sfambach/arduino-atari2600-cart-reader/README.md

# Atari 2600 Cartridge Reader

Arduino firmware for dumping Atari 2600 cartridges, including bankswitched games.

Project page: https://www.fambach.net/ (Retro Projekt – Atari 2600 ROM einlesen)

## Boards

| Board | Address bus | Data bus |
|---|---|---|
| Arduino Mega 2560 | A0-A7 = PA0-PA7, A8-A12 = PC0-PC4 | D0-D7 = PL0-PL7 |
| Arduino Uno / Nano | 2 × 74HC595 on SPI (MOSI D11, SCK D13, latch A2): U1 = A0-A7, U2 = A8-A12 | D0-D7 = D2-D9 |
| Uno / Nano, MCP23017 boards | MCP23017 (I2C 0x20): GPA0-7 = A0-A7, GPB0-4 = A8-A12; `#define ADDR_MCP23017` in `hal.h` | D0-D7 = D2-D9 |

Cartridge slot: pin 23 = switched +5 V (BC327, LOW on D10 for Uno/Nano, D8 for Mega; sense on A0), pins 12 and 24 = GND. Read button on A1; reset button on the Arduino RESET line (Uno and Mega shields).

Boards (THT, KiCad) for Uno, Mega and Nano, plus MCP23017 variants for Uno and Nano: [`hardware/`](hardware/).

## Bankswitching

| Scheme | Size | Status |
|---|---|---|
| 2K, 4K | 2/4 KB | |
| F8, F6, F4 (+SC) | 8/16/32 KB | |
| E0 (Parker Bros.) | 8 KB | |
| E7 (M-Network) | 16 KB | |
| FA (CBS RAM+) | 12 KB | |
| FE (Activision) | 8 KB | experimental |
| 3F (Tigervision) | 8 KB+ (`D 3F <kb>`) | experimental |

Untested on hardware so far.

## Usage

Serial 115200 baud: `L` lists schemes, `D <scheme> [kb]` dumps, `P <hexaddr>` reads one byte, `S` prints the orientation and supply readings. The read button (A1) repeats the last `D` command (4K until one was given); `dump.py <port> listen <prefix>` saves those dumps. The cartridge is powered only during `D`, `P`, `S` and a button read, and only after the orientation check passed (experimental, see [`hardware/`](hardware/)).

```
pip install pyserial
python3 tools/dump.py /dev/ttyACM0 F8 game.bin
```

Test the dump with the emulator [Stella](https://stella-emu.github.io/).

## Credits

- [retrocartdumper](https://github.com/SvOlli/retrocartdumper) by Sven Oliver Moll (GPLv3)
- [Cart Reader](https://github.com/sanni/cartreader) by sanni (GPLv3)
- [vcsreaderfw](https://github.com/keoni29/vcsreaderfw) by Koen van Vliet (MIT)

## Authors

- **Stefan Fambach** (SteFam) – idea and concept, review and testing – https://www.fambach.net
- **Claude** (Anthropic AI) – implementation, via Claude Code

## AI disclosure

This project is built with AI assistance. Stefan Fambach had the idea, wrote the concept and reviews and tests every change; the implementation (schematics, PCB design files, firmware and documentation) is written largely by Claude (Anthropic) via Claude Code.

## License

GPLv3
