sfambach/arduino-atari2600-cart-reader/hardware/mega/atari2600-cart-reader-mega-platine.png

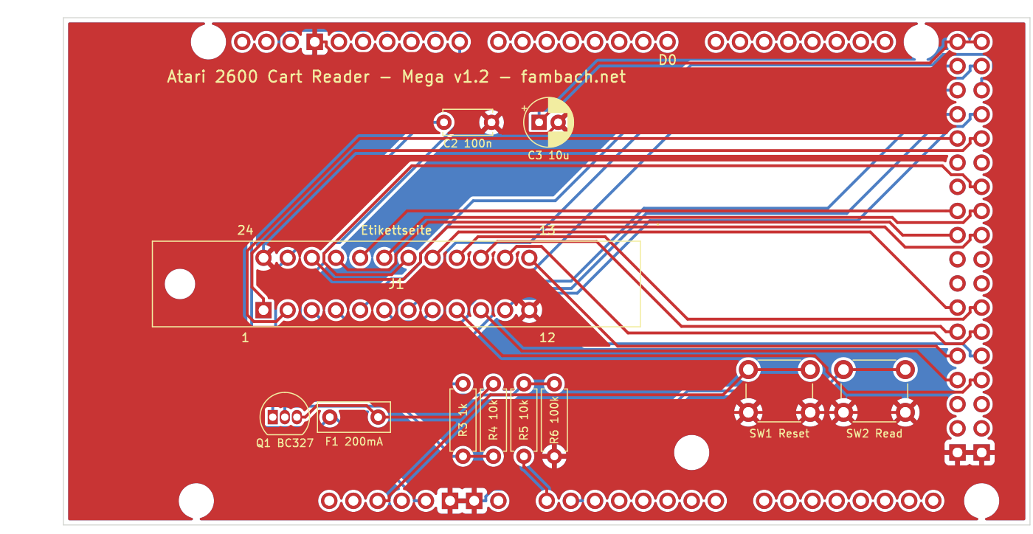
hardware/mega/atari2600-cart-reader-mega-platine.png
