sfambach/arduino-atari2600-cart-reader/hardware/nano-mcp23017/atari2600-cart-reader-nano-mcp23017-platine.png

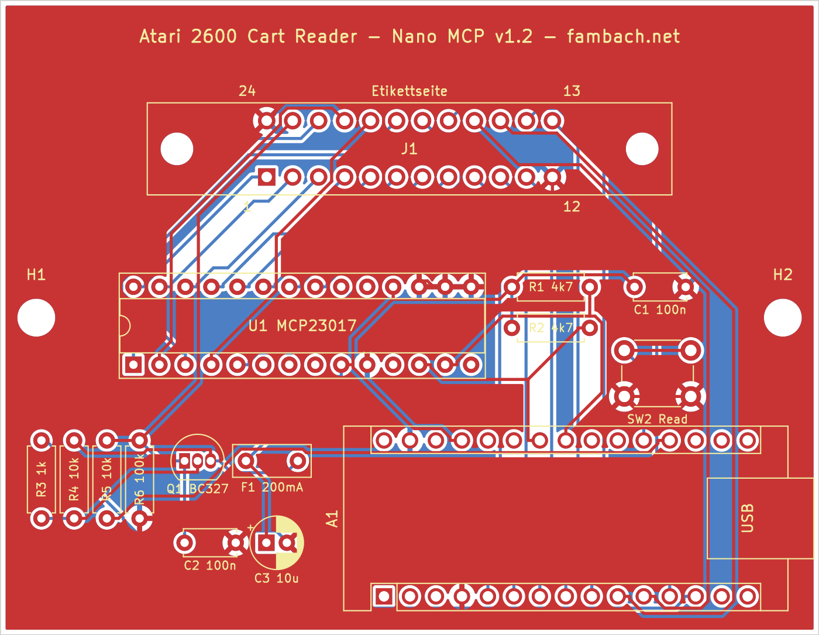
hardware/nano-mcp23017/atari2600-cart-reader-nano-mcp23017-platine.png
