sfambach/arduino-atari2600-cart-reader/hardware/nano/atari2600-cart-reader-nano-platine.png

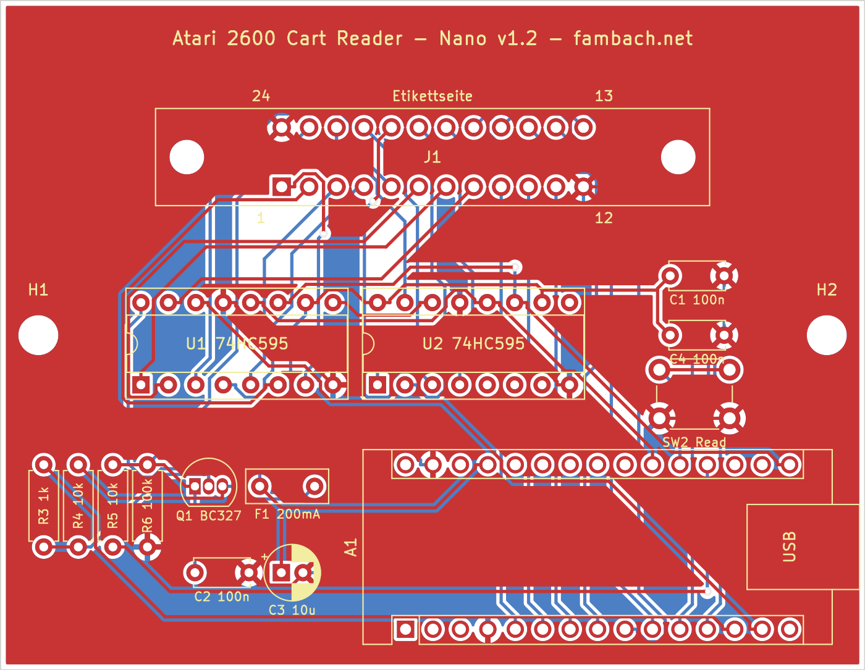
hardware/nano/atari2600-cart-reader-nano-platine.png
