sfambach/arduino-atari2600-cart-reader/hardware/pinout/pinout.png

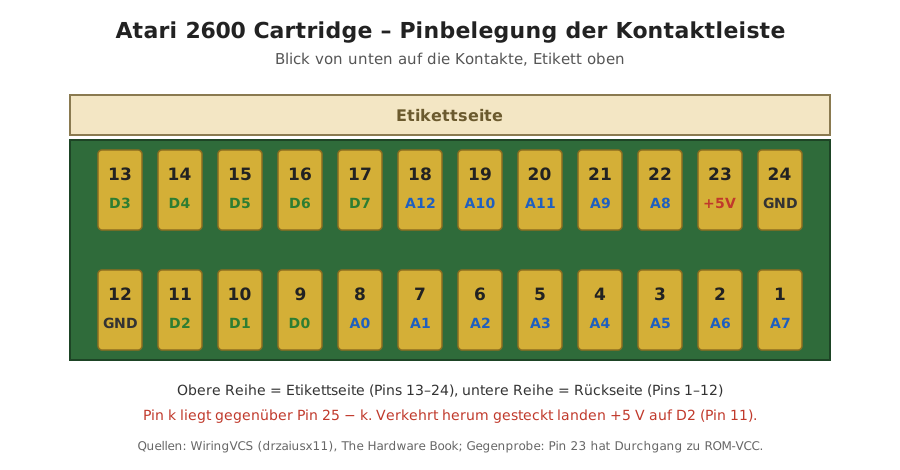
hardware/pinout/pinout.png
