sfambach/arduino-atari2600-cart-reader/hardware/slot-drawing/slot-masse.png

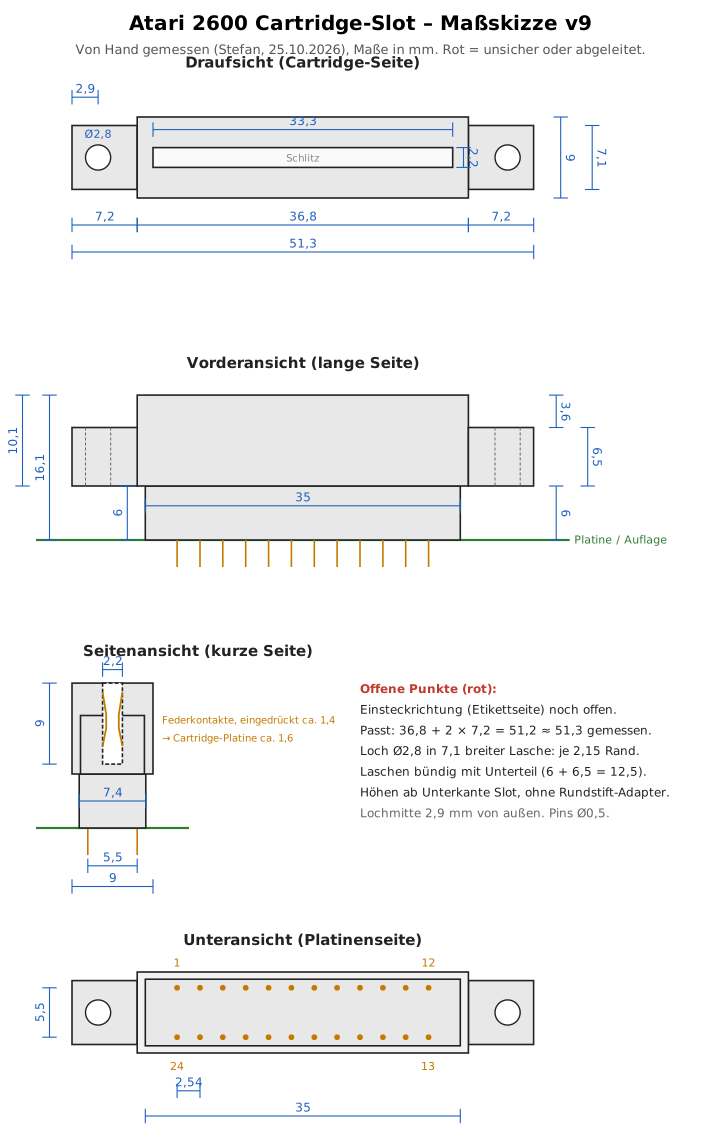
hardware/slot-drawing/slot-masse.png
