sfambach/arduino-atari2600-cart-reader/hardware/switch/schalter.png

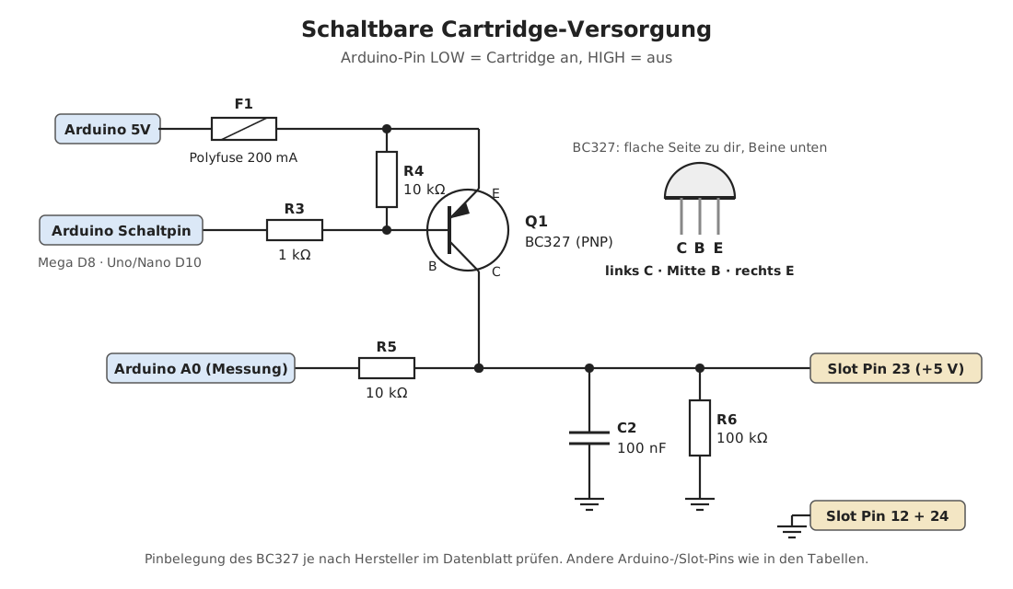
hardware/switch/schalter.png
