sfambach/arduino-atari2600-cart-reader/hardware/uno-mcp23017/atari2600-cart-reader-uno-mcp23017-platine.png

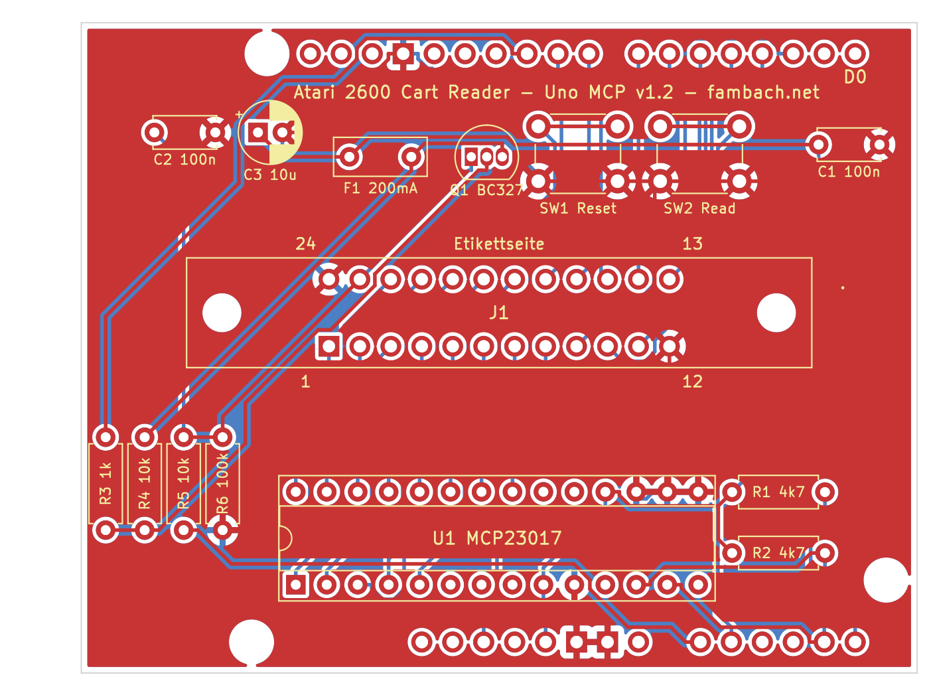
hardware/uno-mcp23017/atari2600-cart-reader-uno-mcp23017-platine.png
