sfambach/arduino-atari2600-cart-reader/hardware/uno/atari2600-cart-reader-uno-platine.png

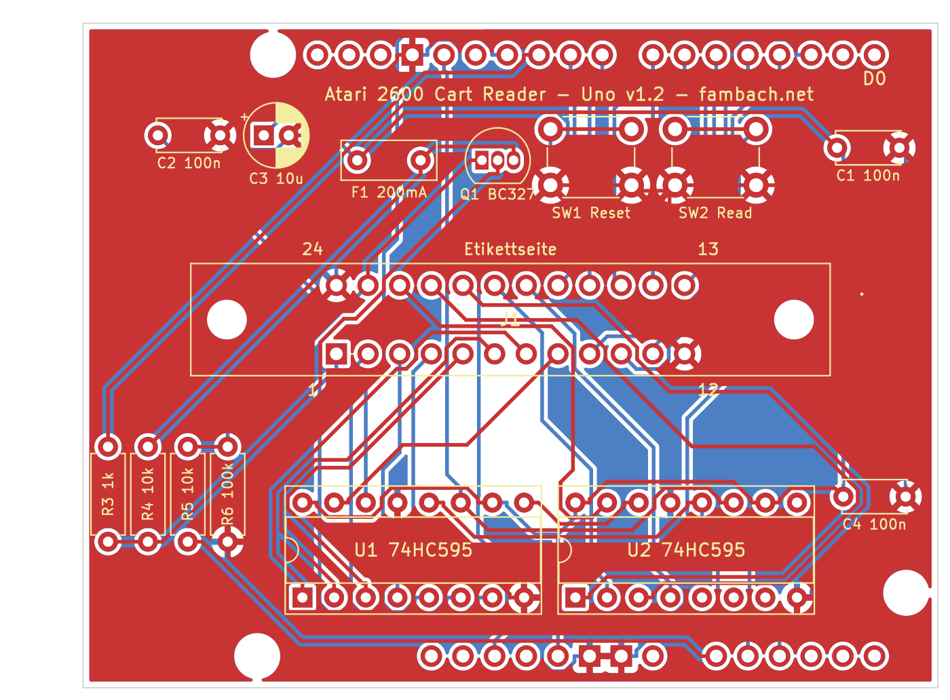
hardware/uno/atari2600-cart-reader-uno-platine.png
