sfambach/arduino-atari2600-cart-reader/hardware/mega/atari2600-cart-reader-mega-schaltplan.pdf

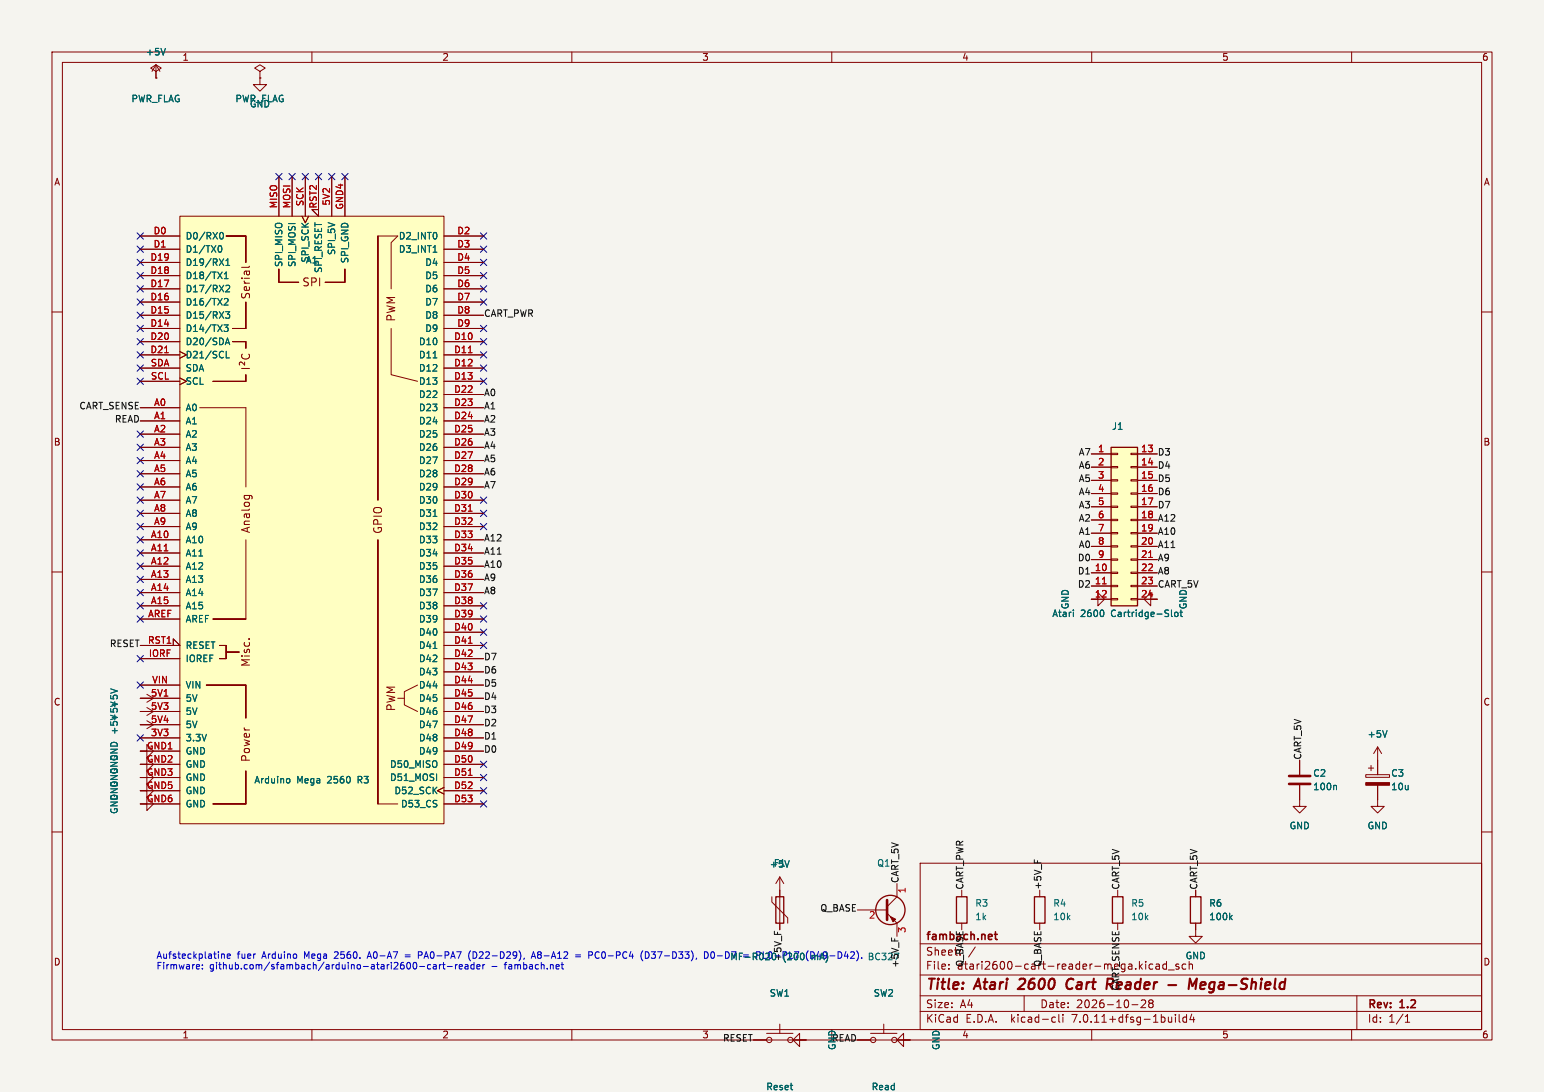
[picture p9: page 1]

A1 Arduino Mega 2560 R3
J1 Atari 2600 Cartridge-Slot GND GND

Id: 1/1 Title: Atari 2600 Cart Reader - Mega-Shield
