sfambach/arduino-atari2600-cart-reader/hardware/nano-mcp23017/atari2600-cart-reader-nano-mcp23017-schaltplan.pdf

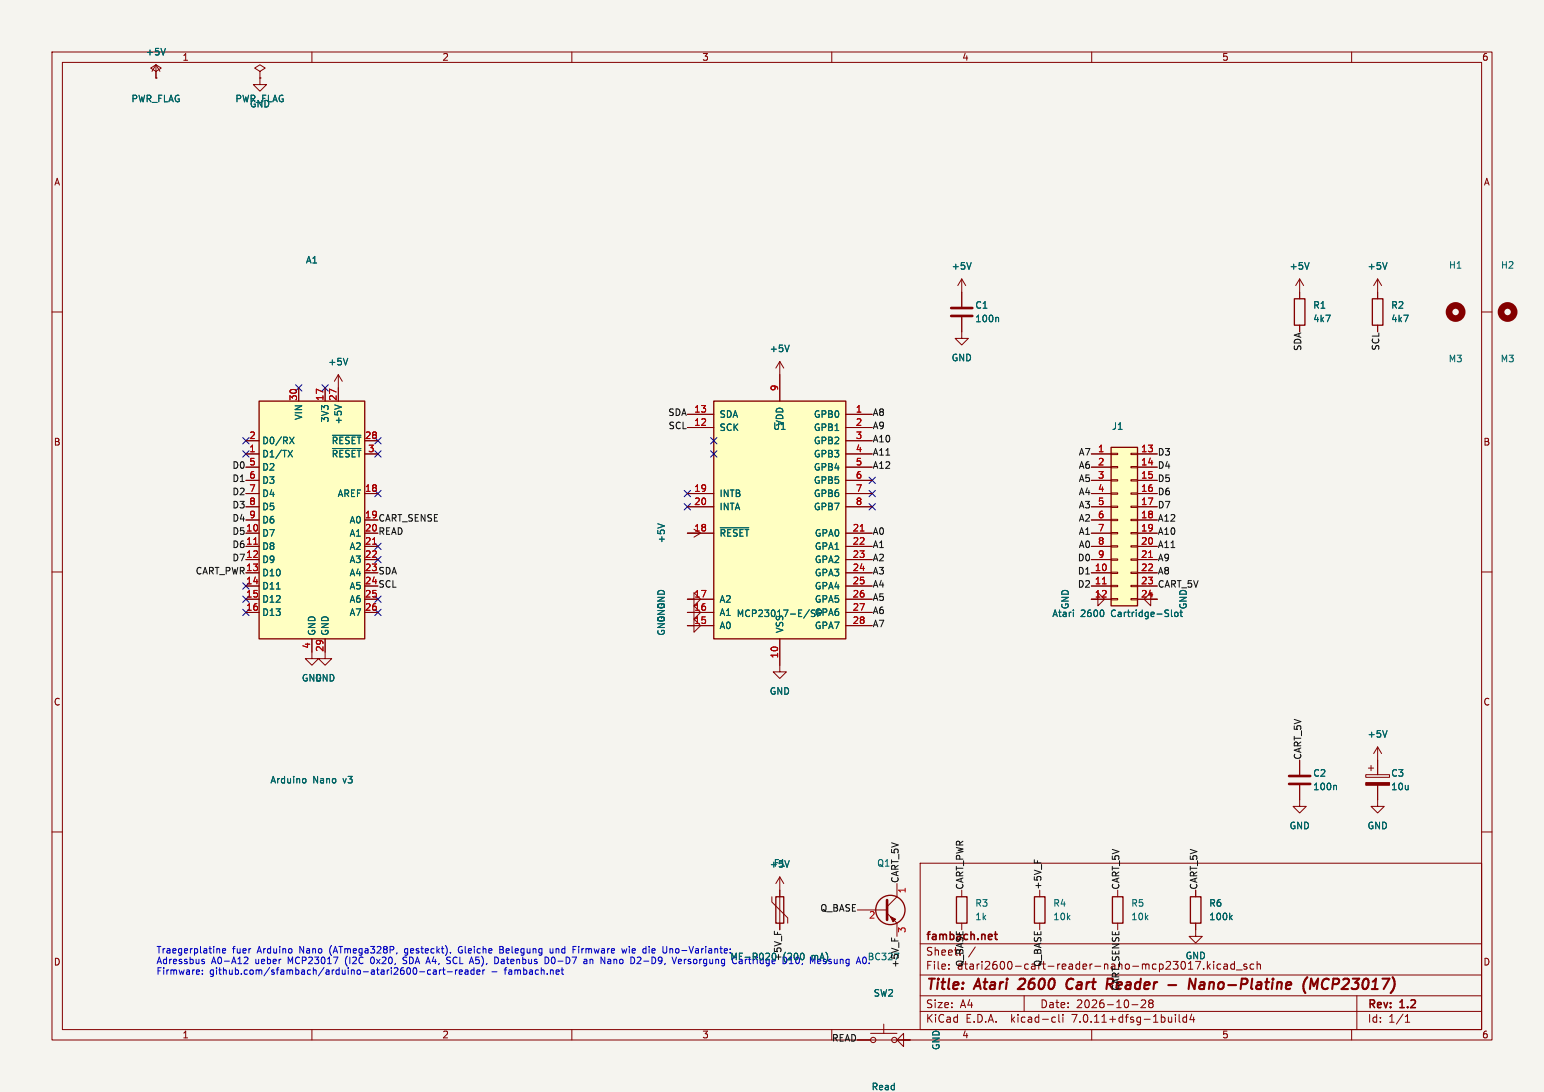
[picture p10: page 1]

4 D2 5 D3 6 D4 7 D5 8 D6 9 A1 Arduino Nano v3 GND GND GND GND
~{RESET} 28 GND 29

9 F1 MF-R020 (200 mA) GND GND +5V GND
