sfambach/arduino-atari2600-cart-reader/hardware/nano/atari2600-cart-reader-nano-schaltplan.pdf

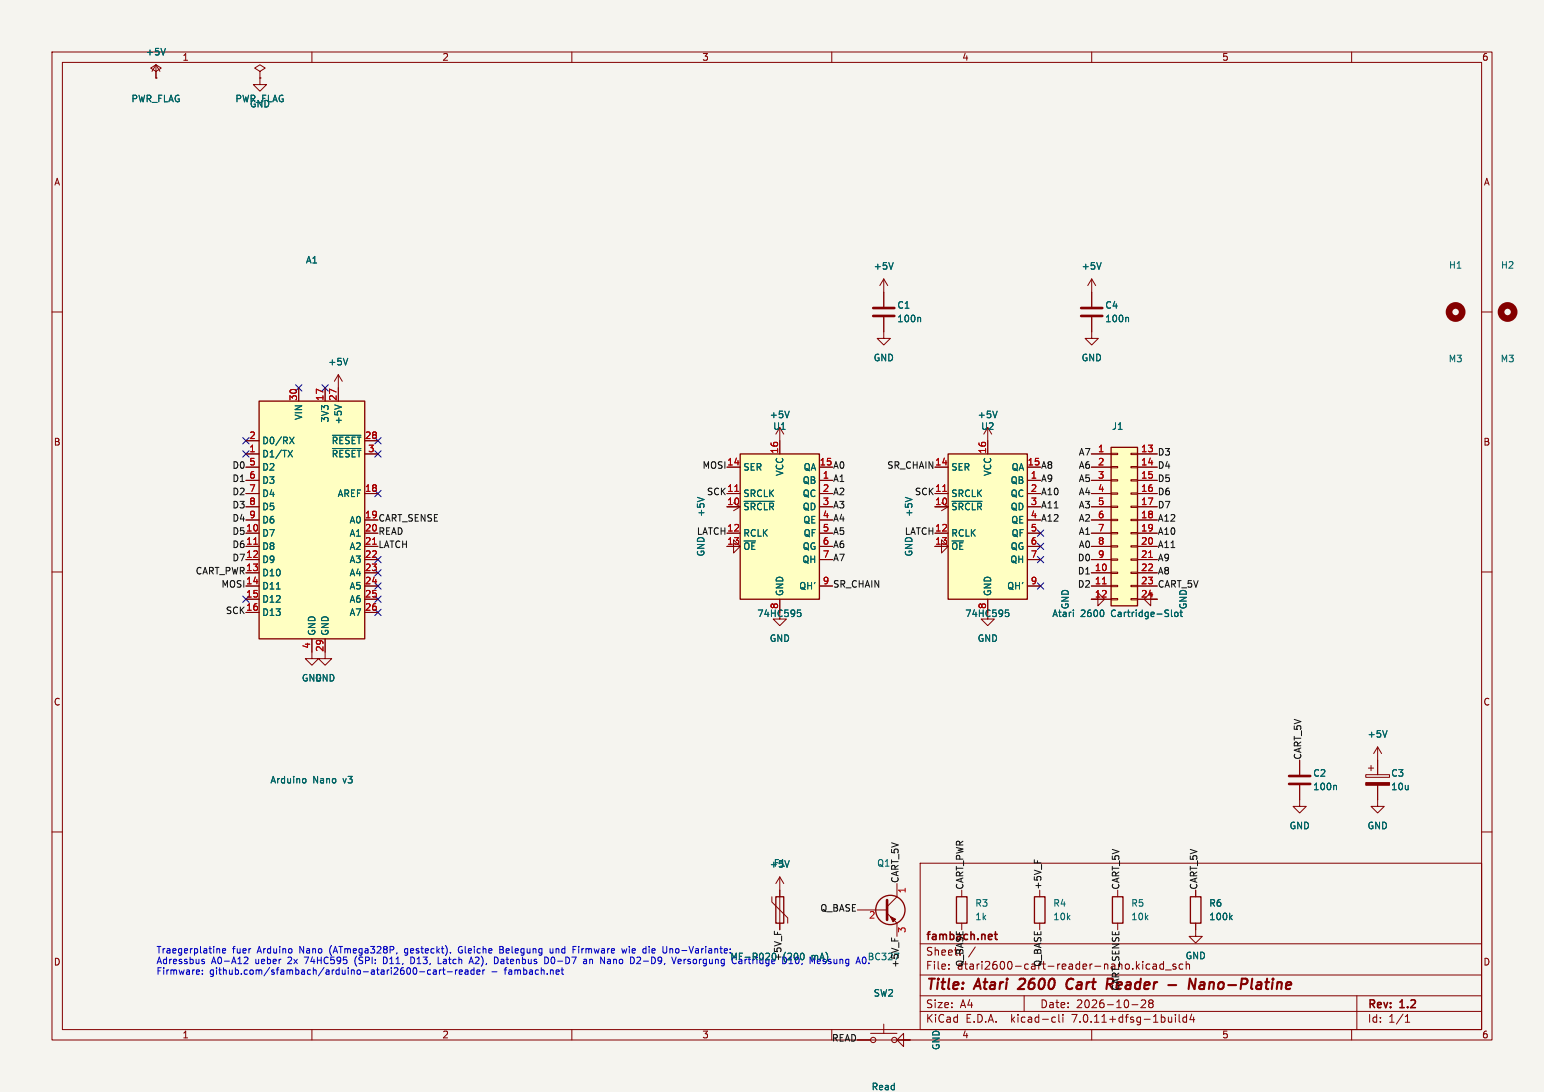
[picture p11: page 1]

File: atari2600-cart-reader-nano.kicad_sch Sheet: / fambach.net +5V

Id: 1/1 Title: Atari 2600 Cart Reader - Nano-Platine
