sfambach/arduino-atari2600-cart-reader/hardware/uno/atari2600-cart-reader-uno-schaltplan.pdf

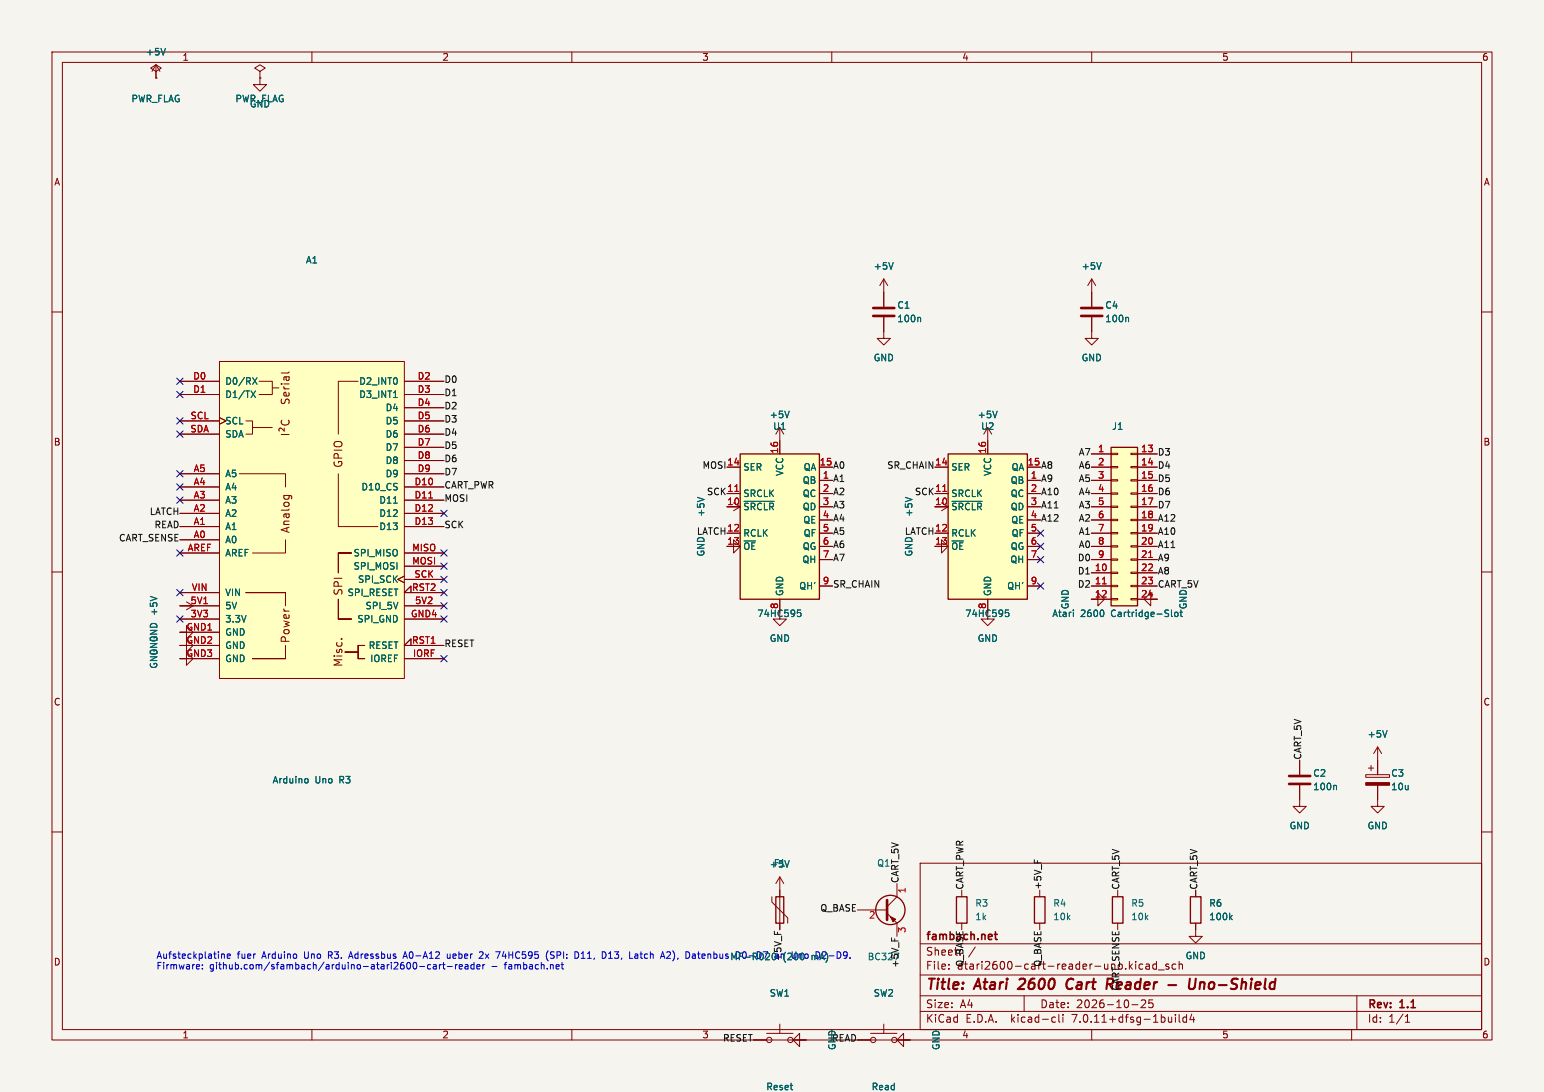
[picture p12: page 1]

J1 Atari 2600 Cartridge-Slot GND +5V GND

Id: 1/1 Title: Atari 2600 Cart Reader - Uno-Shield
