sfambach/arduino-atari2600-cart-reader/hardware/uno-mcp23017/atari2600-cart-reader-uno-mcp23017-schaltplan.pdf

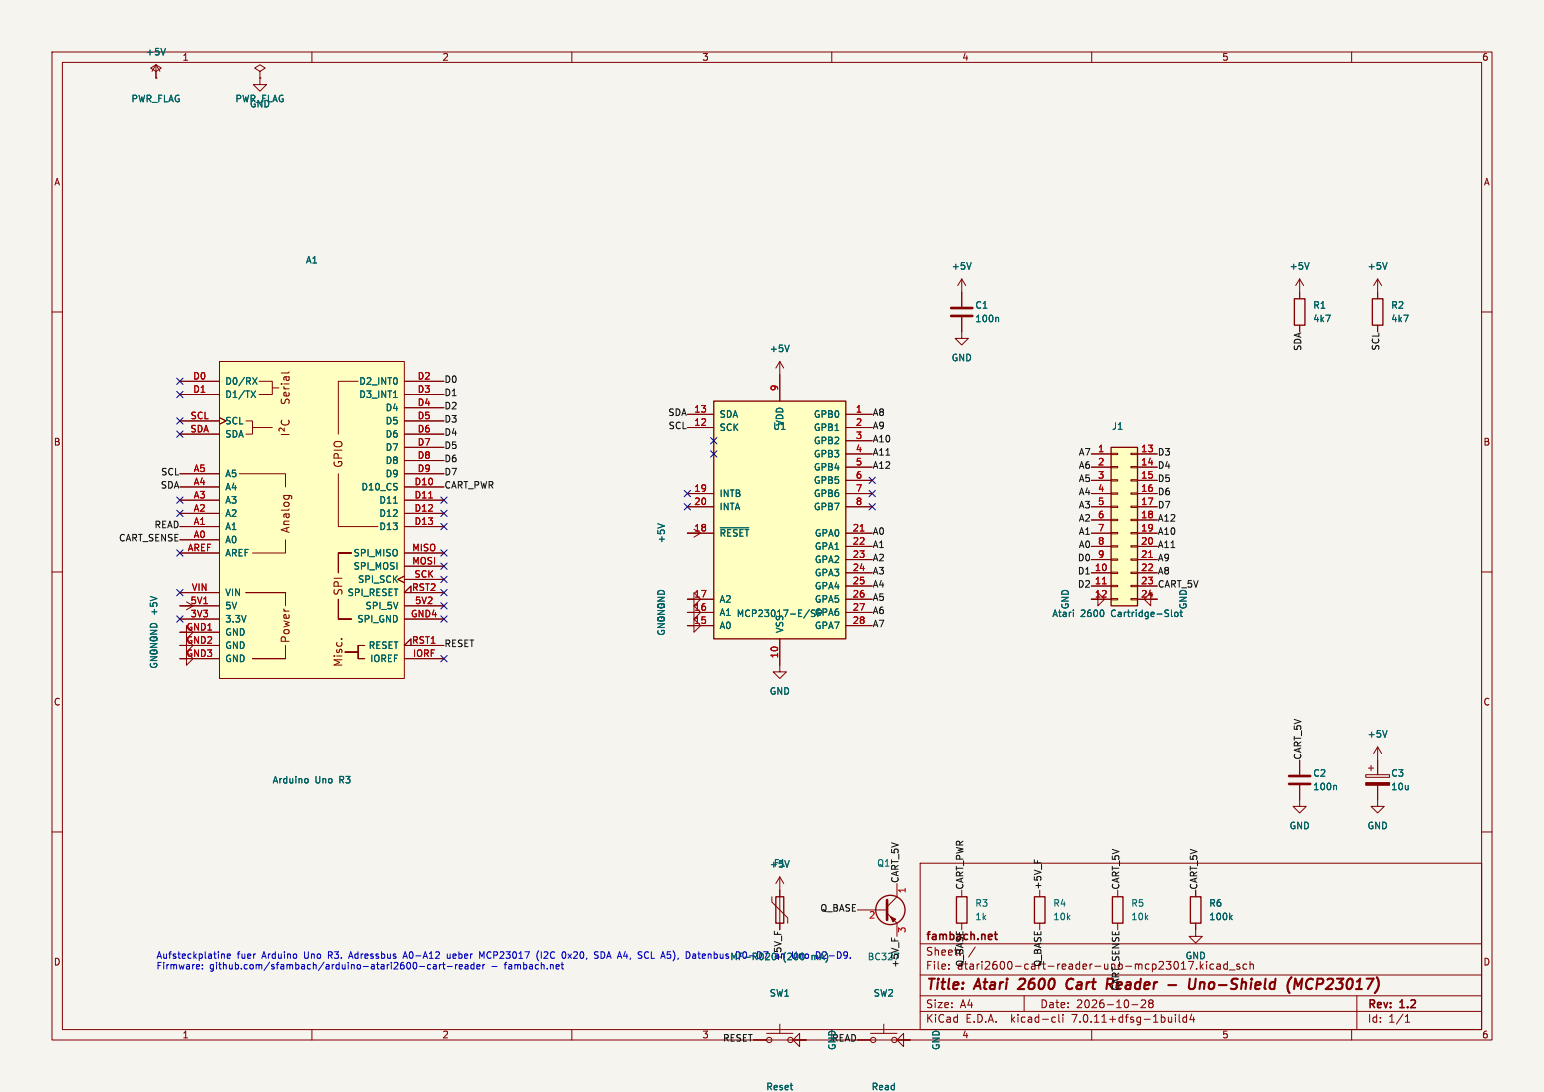
[picture p13: page 1]
