sfambach/arduino-atari2600-cart-reader/hardware/nano-mcp23017/atari2600-cart-reader-nano-mcp23017.kicad_pcb

## KiCad design hardware/nano-mcp23017/atari2600-cart-reader-nano-mcp23017.kicad_pcb (2026-10-28)

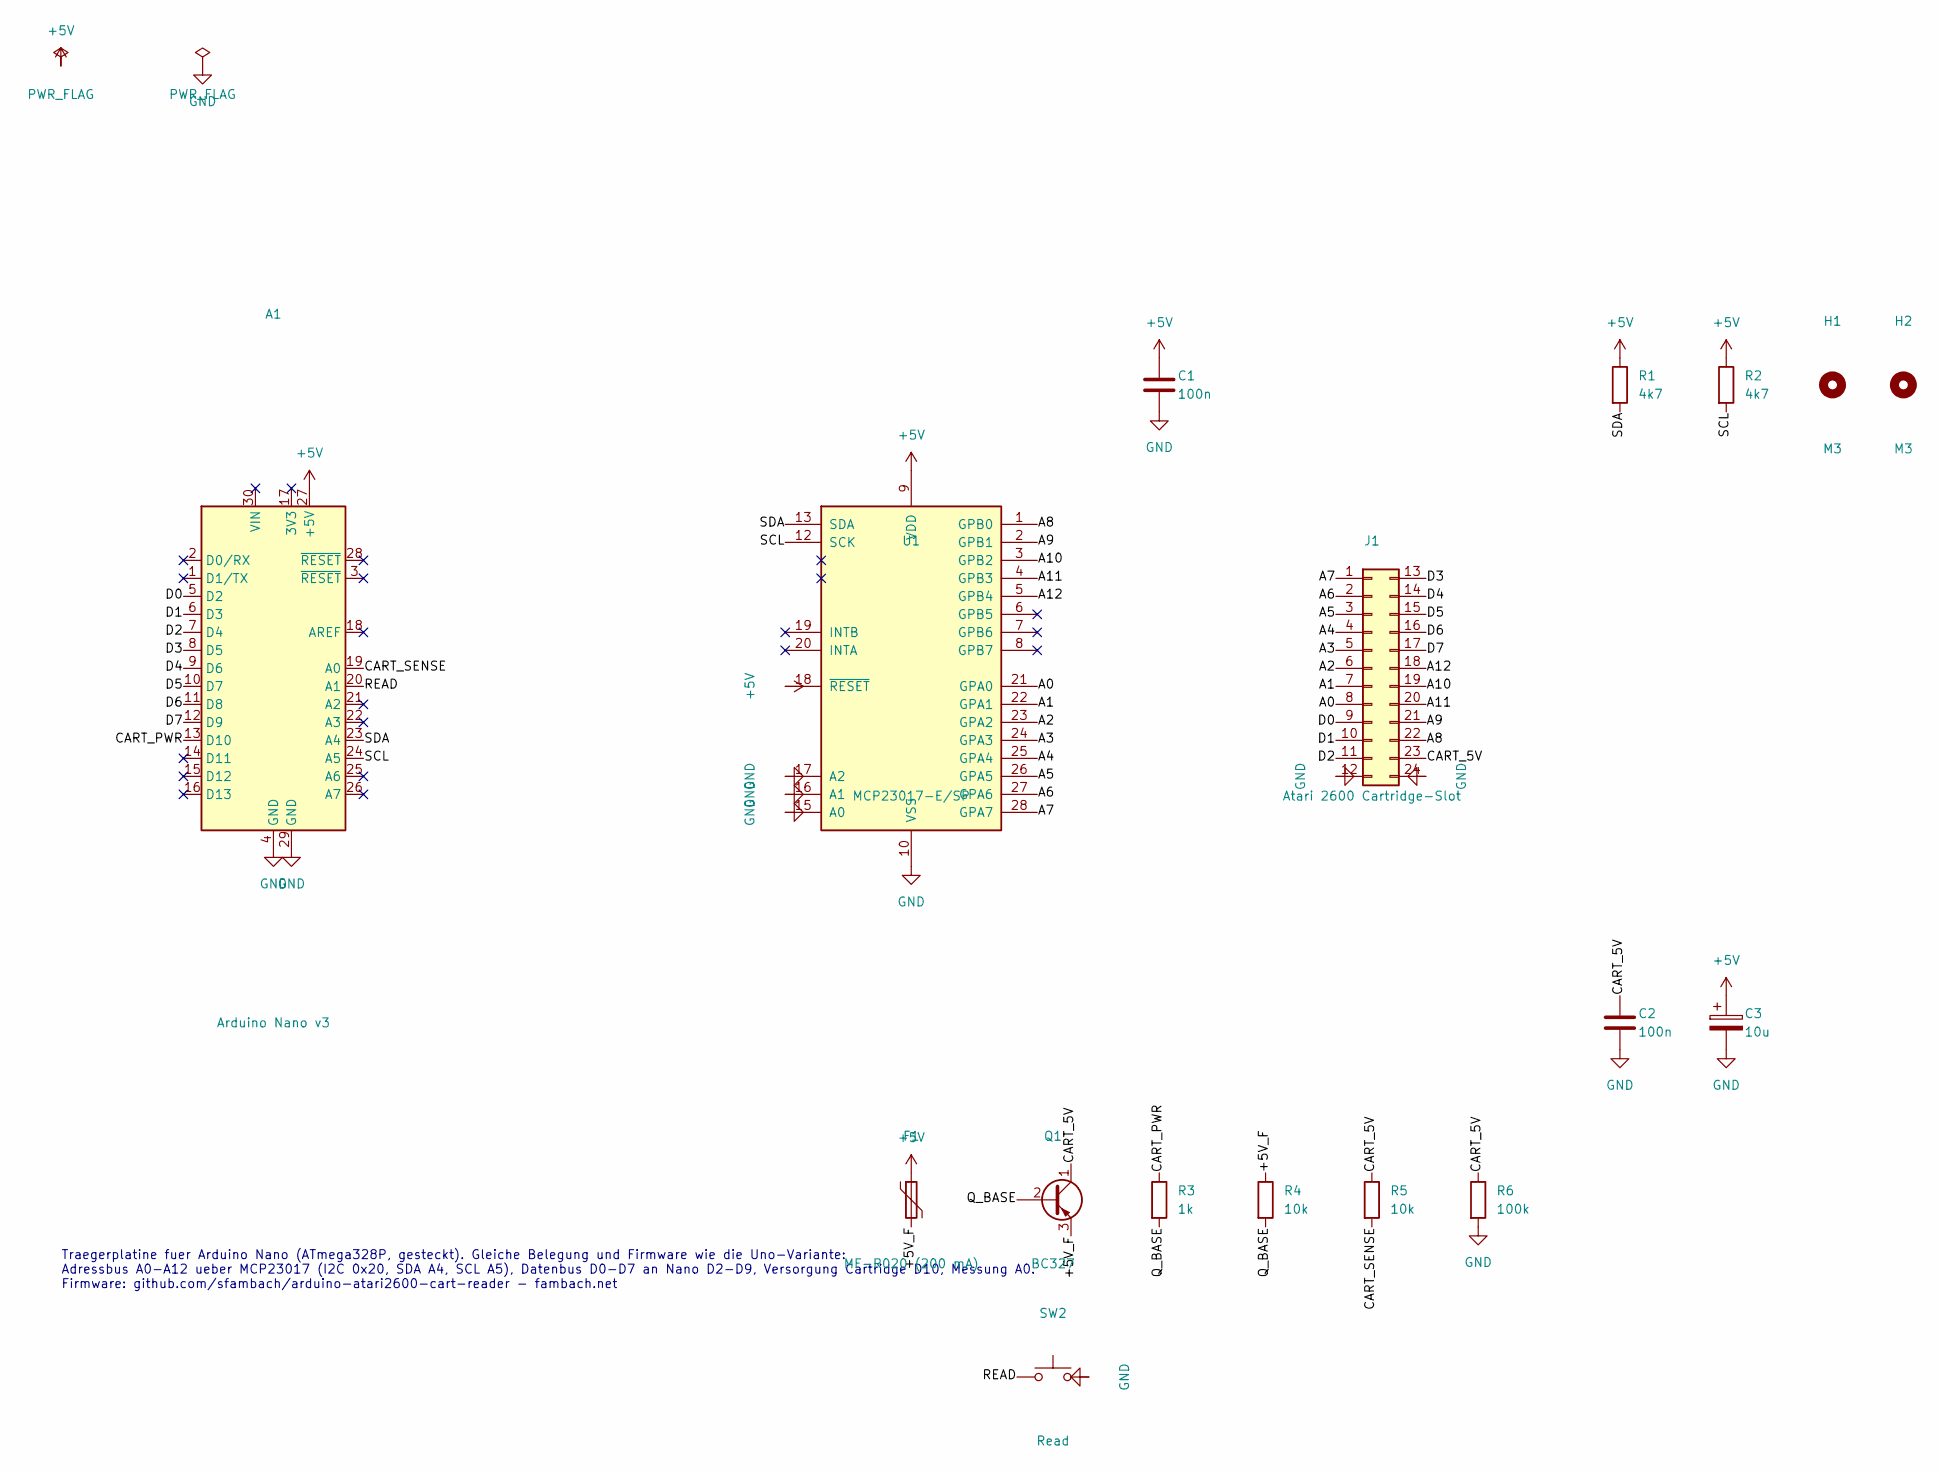
[picture p14: schematic atari2600-cart-reader-nano-mcp23017.kicad_sch, Atari 2600 Cart Reader - Nano-Platine (MCP23017)]

Parts:
A1: Arduino Nano v3; Arduino_Nano
C1, C2: 100n; C_Disc_D5.0mm_W2.5mm_P5.00mm
C3: 10u; CP_Radial_D5.0mm_P2.00mm
F1: MF-R020 (200 mA); Fuse_PTC_Radial_P5.08mm
H1, H2: M3; MountingHole_3.2mm_M3
J1: Atari 2600 Cartridge-Slot; Atari2600_Cart_Slot_2x12_P2.54mm_Row5.50mm_Guide
Q1: BC327; TO-92_Inline
R1, R2: 4k7; R_Axial_DIN0207_L6.3mm_D2.5mm_P7.62mm_Horizontal
R3: 1k; R_Axial_DIN0207_L6.3mm_D2.5mm_P7.62mm_Horizontal
R4, R5: 10k; R_Axial_DIN0207_L6.3mm_D2.5mm_P7.62mm_Horizontal
R6: 100k; R_Axial_DIN0207_L6.3mm_D2.5mm_P7.62mm_Horizontal
SW2: Read; SW_PUSH_6mm
U1: MCP23017-E/SP; DIP-28_W7.62mm_Socket

Connections:
+5V: A1.27 (+5V), C1.1, C3.1, F1.1, R1.1, R2.1, U1.9 (VDD), U1.18 (~RESET)
/+5V_F: F1.2, Q1.3 (E), R4.1
/A0: J1.8, U1.21 (GPA0)
/A1: J1.7, U1.22 (GPA1)
/A2: J1.6, U1.23 (GPA2)
/A3: J1.5, U1.24 (GPA3)
/A4: J1.4, U1.25 (GPA4)
/A5: J1.3, U1.26 (GPA5)
/A6: J1.2, U1.27 (GPA6)
/A7: J1.1, U1.28 (GPA7)
/A8: J1.22, U1.1 (GPB0)
/A9: J1.21, U1.2 (GPB1)
/A10: J1.19, U1.3 (GPB2)
/A11: J1.20, U1.4 (GPB3)
/A12: J1.18, U1.5 (GPB4)
/CART_5V: C2.1, J1.23, Q1.1 (C), R5.1, R6.1
/CART_PWR: A1.13 (D10), R3.1
/CART_SENSE: A1.19 (A0), R5.2
/D0: A1.5 (D2), J1.9
/D1: A1.6 (D3), J1.10
/D2: A1.7 (D4), J1.11
/D3: A1.8 (D5), J1.13
/D4: A1.9 (D6), J1.14
/D5: A1.10 (D7), J1.15
/D6: A1.11 (D8), J1.16
/D7: A1.12 (D9), J1.17
/Q_BASE: Q1.2 (B), R3.2, R4.2
/READ: A1.20 (A1), SW2.1
/SCL: A1.24 (A5), R2.2, U1.12 (SCK)
/SDA: A1.23 (A4), R1.2, U1.13 (SDA)
GND: A1.4 (GND), A1.29 (GND), C1.2, C2.2, C3.2, J1.12, J1.24, R6.2, SW2.2, U1.10 (VSS), U1.15 (A0), U1.16 (A1), U1.17 (A2)

Notes on the sheet:
Traegerplatine fuer Arduino Nano (ATmega328P, gesteckt). Gleiche Belegung und Firmware wie die Uno-Variante: Adressbus A0-A12 ueber MCP23017 (I2C 0x20, SDA A4, SCL A5), Datenbus D0-D7 an Nano D2-D9, Versorgung Cartridge D10, Messung A0. Firmware: github.com/sfambach/arduino-atari2600-cart-reader - 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

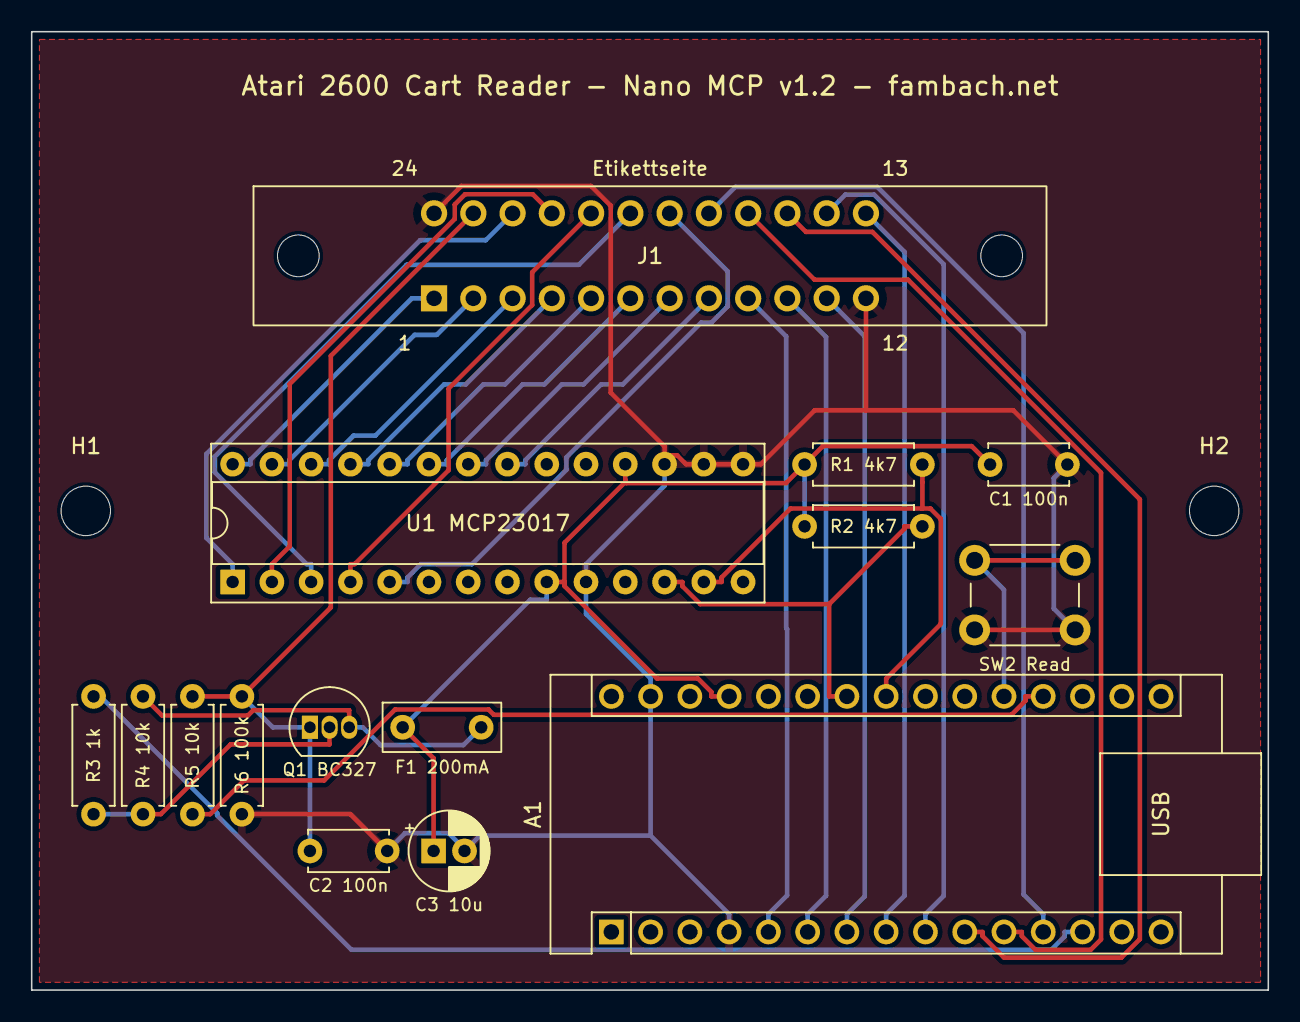
[picture p15: board atari2600-cart-reader-nano-mcp23017.kicad_pcb from above]

Board: 2 copper layers, 80.0 x 62.0 mm, 17 parts (0 on the bottom side), 31 nets.
