sfambach/arduino-atari2600-cart-reader/hardware/mega/atari2600-cart-reader-mega.kicad_pcb

## KiCad design hardware/mega/atari2600-cart-reader-mega.kicad_pcb (2026-10-28)

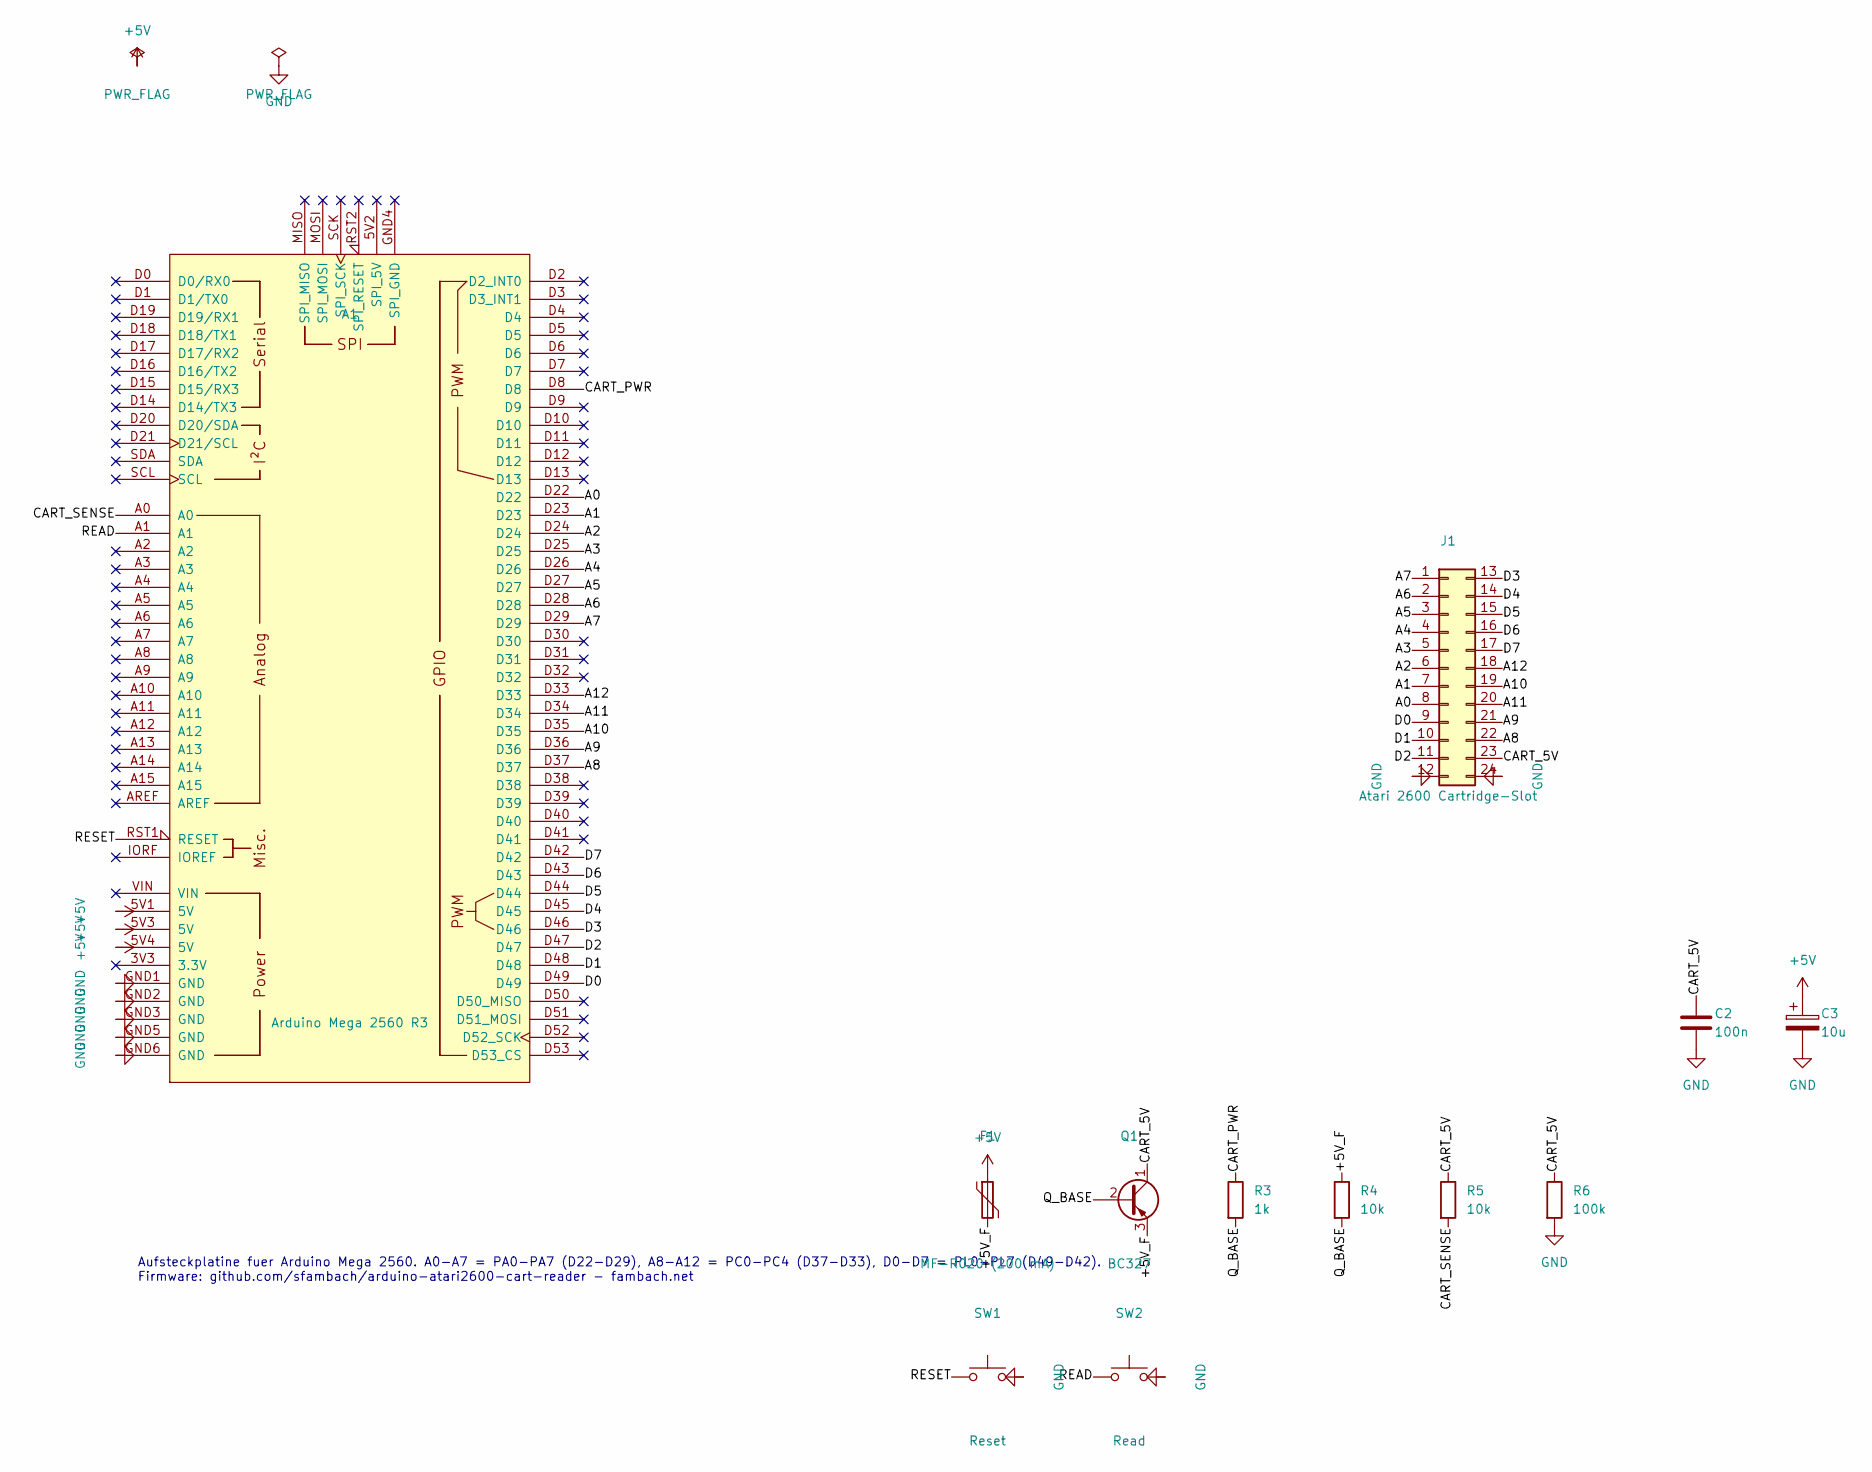
[picture p16: schematic atari2600-cart-reader-mega.kicad_sch, Atari 2600 Cart Reader - Mega-Shield]

Parts:
A1: Arduino Mega 2560 R3; Arduino_Mega2560_R3_Shield
C2: 100n; C_Disc_D5.0mm_W2.5mm_P5.00mm
C3: 10u; CP_Radial_D5.0mm_P2.00mm
F1: MF-R020 (200 mA); Fuse_PTC_Radial_P5.08mm
J1: Atari 2600 Cartridge-Slot; Atari2600_Cart_Slot_2x12_P2.54mm_Row5.50mm_Guide
Q1: BC327; TO-92_Inline
R3: 1k; R_Axial_DIN0207_L6.3mm_D2.5mm_P7.62mm_Horizontal
R4, R5: 10k; R_Axial_DIN0207_L6.3mm_D2.5mm_P7.62mm_Horizontal
R6: 100k; R_Axial_DIN0207_L6.3mm_D2.5mm_P7.62mm_Horizontal
SW1: Reset; SW_PUSH_6mm
SW2: Read; SW_PUSH_6mm

Connections:
+5V: A1.5V1 (5V), A1.5V3 (5V), A1.5V4 (5V), C3.1, F1.1
/+5V_F: F1.2, Q1.3 (E), R4.1
/A0: A1.D22, J1.8
/A1: A1.D23, J1.7
/A2: A1.D24, J1.6
/A3: A1.D25, J1.5
/A4: A1.D26, J1.4
/A5: A1.D27, J1.3
/A6: A1.D28, J1.2
/A7: A1.D29, J1.1
/A8: A1.D37, J1.22
/A9: A1.D36, J1.21
/A10: A1.D35, J1.19
/A11: A1.D34, J1.20
/A12: A1.D33, J1.18
/CART_5V: C2.1, J1.23, Q1.1 (C), R5.1, R6.1
/CART_PWR: A1.D8, R3.1
/CART_SENSE: A1.A0, R5.2
/D0: A1.D49, J1.9
/D1: A1.D48, J1.10
/D2: A1.D47, J1.11
/D3: A1.D46, J1.13
/D4: A1.D45, J1.14
/D5: A1.D44, J1.15
/D6: A1.D43, J1.16
/D7: A1.D42, J1.17
/Q_BASE: Q1.2 (B), R3.2, R4.2
/READ: A1.A1, SW2.1
/RESET: A1.RST1 (RESET), SW1.1
GND: A1.GND1 (GND), A1.GND2 (GND), A1.GND3 (GND), A1.GND5 (GND), A1.GND6 (GND), C2.2, C3.2, J1.12, J1.24, R6.2, SW1.2, SW2.2

Notes on the sheet:
Aufsteckplatine fuer Arduino Mega 2560. A0-A7 = PA0-PA7 (D22-D29), A8-A12 = PC0-PC4 (D37-D33), D0-D7 = PL0-PL7 (D49-D42). Firmware: github.com/sfambach/arduino-atari2600-cart-reader - fambach.net

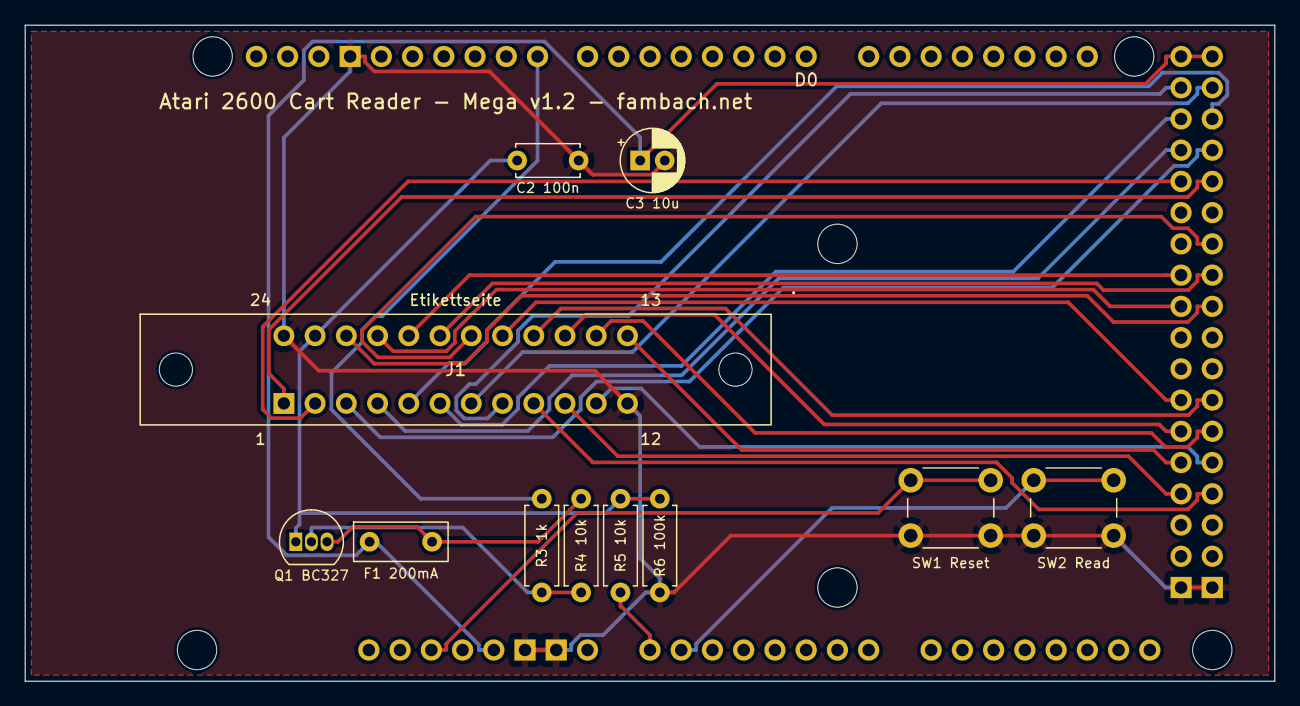
[picture p17: board atari2600-cart-reader-mega.kicad_pcb from above]

Board: 2 copper layers, 101.6 x 53.3 mm, 12 parts (0 on the bottom side), 30 nets.
