sfambach/arduino-atari2600-cart-reader/hardware/uno/atari2600-cart-reader-uno.kicad_pcb

## KiCad design hardware/uno/atari2600-cart-reader-uno.kicad_pcb (2026-10-28)

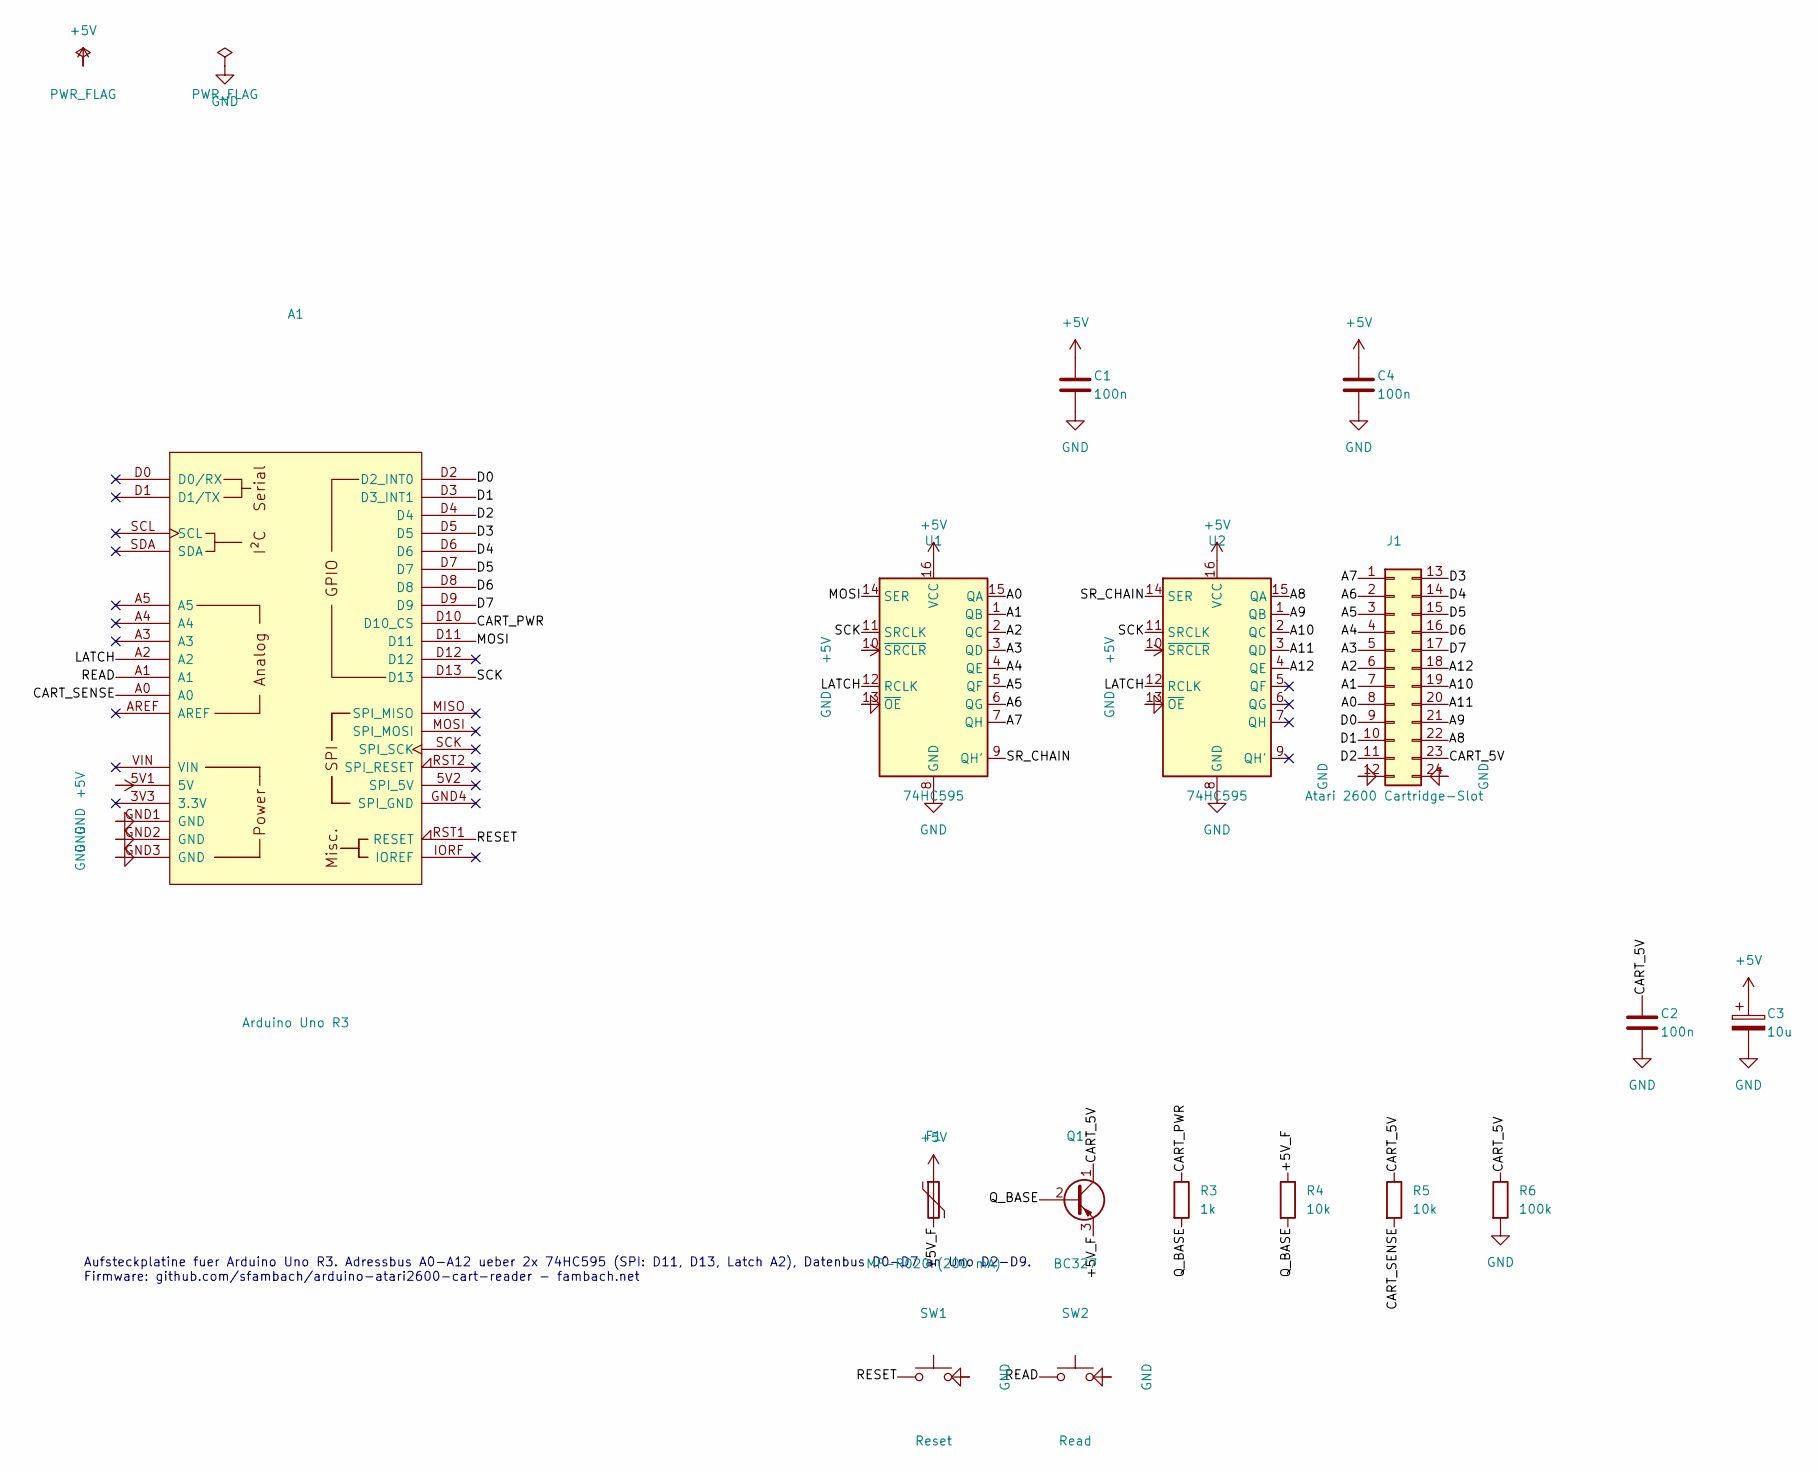
[picture p18: schematic atari2600-cart-reader-uno.kicad_sch, Atari 2600 Cart Reader - Uno-Shield]

Parts:
A1: Arduino Uno R3; Arduino_Uno_R3_Shield
C1, C2, C4: 100n; C_Disc_D5.0mm_W2.5mm_P5.00mm
C3: 10u; CP_Radial_D5.0mm_P2.00mm
F1: MF-R020 (200 mA); Fuse_PTC_Radial_P5.08mm
J1: Atari 2600 Cartridge-Slot; Atari2600_Cart_Slot_2x12_P2.54mm_Row5.50mm_Guide
Q1: BC327; TO-92_Inline
R3: 1k; R_Axial_DIN0207_L6.3mm_D2.5mm_P7.62mm_Horizontal
R4, R5: 10k; R_Axial_DIN0207_L6.3mm_D2.5mm_P7.62mm_Horizontal
R6: 100k; R_Axial_DIN0207_L6.3mm_D2.5mm_P7.62mm_Horizontal
SW1: Reset; SW_PUSH_6mm
SW2: Read; SW_PUSH_6mm
U1, U2: 74HC595; DIP-16_W7.62mm_Socket

Connections:
+5V: A1.5V1 (5V), C1.1, C3.1, C4.1, F1.1, U1.10 (~SRCLR), U1.16 (VCC), U2.10 (~SRCLR), U2.16 (VCC)
/+5V_F: F1.2, Q1.3 (E), R4.1
/A0: J1.8, U1.15 (QA)
/A1: J1.7, U1.1 (QB)
/A2: J1.6, U1.2 (QC)
/A3: J1.5, U1.3 (QD)
/A4: J1.4, U1.4 (QE)
/A5: J1.3, U1.5 (QF)
/A6: J1.2, U1.6 (QG)
/A7: J1.1, U1.7 (QH)
/A8: J1.22, U2.15 (QA)
/A9: J1.21, U2.1 (QB)
/A10: J1.19, U2.2 (QC)
/A11: J1.20, U2.3 (QD)
/A12: J1.18, U2.4 (QE)
/CART_5V: C2.1, J1.23, Q1.1 (C), R5.1, R6.1
/CART_PWR: A1.D10 (D10_CS), R3.1
/CART_SENSE: A1.A0, R5.2
/D0: A1.D2 (D2_INT0), J1.9
/D1: A1.D3 (D3_INT1), J1.10
/D2: A1.D4, J1.11
/D3: A1.D5, J1.13
/D4: A1.D6, J1.14
/D5: A1.D7, J1.15
/D6: A1.D8, J1.16
/D7: A1.D9, J1.17
/LATCH: A1.A2, U1.12 (RCLK), U2.12 (RCLK)
/MOSI: A1.D11, U1.14 (SER)
/Q_BASE: Q1.2 (B), R3.2, R4.2
/READ: A1.A1, SW2.1
/RESET: A1.RST1 (RESET), SW1.1
/SCK: A1.D13, U1.11 (SRCLK), U2.11 (SRCLK)
/SR_CHAIN: U1.9 (QH'), U2.14 (SER)
GND: A1.GND1 (GND), A1.GND2 (GND), A1.GND3 (GND), C1.2, C2.2, C3.2, C4.2, J1.12, J1.24, R6.2, SW1.2, SW2.2, U1.8 (GND), U1.13 (~OE), U2.8 (GND), U2.13 (~OE)

Notes on the sheet:
Aufsteckplatine fuer Arduino Uno R3. Adressbus A0-A12 ueber 2x 74HC595 (SPI: D11, D13, Latch A2), Datenbus D0-D7 an Uno D2-D9. Firmware: github.com/sfambach/arduino-atari2600-cart-reader - fambach.net

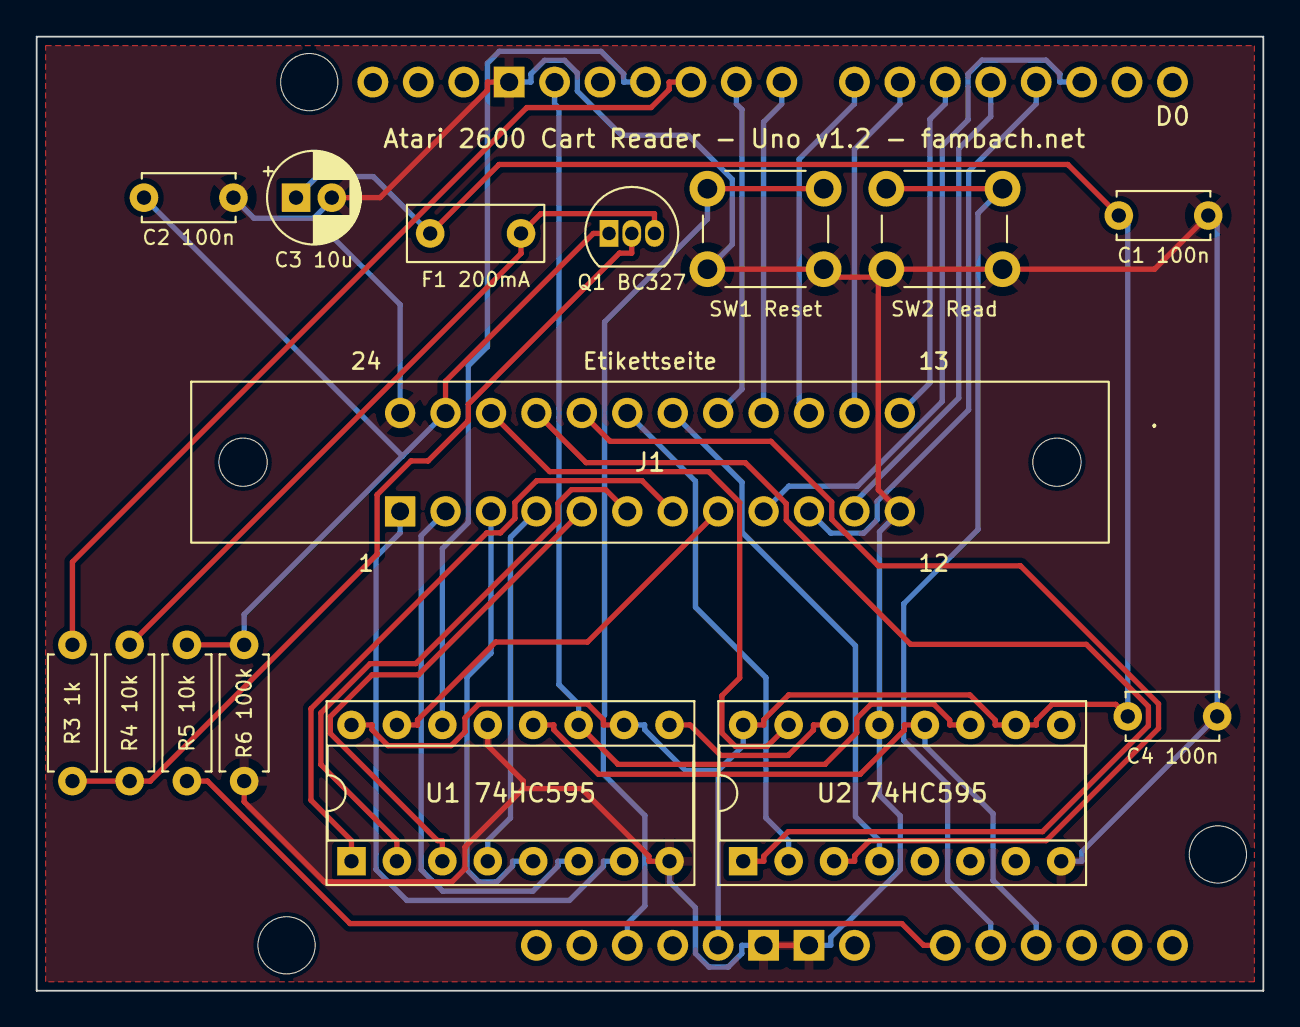
[picture p19: board atari2600-cart-reader-uno.kicad_pcb from above]

Board: 2 copper layers, 68.6 x 53.3 mm, 16 parts (0 on the bottom side), 34 nets.
