sfambach/arduino-atari2600-cart-reader/AtariCartReader/hal.h

#pragma once
#include <Arduino.h>

// Hardware abstraction: address bus A0-A12, data bus D0-D7, switched cartridge supply.
void halInit();                    // bus released, cartridge supply off
void halRelease();                 // all cartridge lines to input without pull-ups
void halDrive();                   // address bus to output
void halPullupD2(bool on);         // weak pull-up on data line D2 for the orientation check
void halSetAddr(uint16_t addr);
uint8_t halReadData();
void halWriteData(uint8_t data);   // drives the data bus
void halReleaseData();             // data bus back to input

#if defined(__AVR_ATmega2560__)
// Arduino Mega 2560, 40-pin connector:
// A0-A7 = PA0-PA7, A8-A12 = PC0-PC4, D0-D7 = PL0-PL7
const uint8_t CART_PWR = 8;        // PH5, LOW = cartridge on (BC327)
const uint8_t CART_SENSE = A0;
inline void halRelease() {
  DDRA = 0x00; PORTA = 0x00;
  DDRC &= 0xE0; PORTC &= 0xE0;
  DDRL = 0x00; PORTL = 0x00;
}
inline void halDrive() {
  PORTA = 0x00; DDRA = 0xFF;
  PORTC &= 0xE0; DDRC |= 0x1F;
}
inline void halPullupD2(bool on) { if (on) PORTL |= 0x04; else PORTL &= ~0x04; }
inline void halInit() { halRelease(); }
inline void halSetAddr(uint16_t addr) {
  PORTA = addr & 0xFF;
  PORTC = (PORTC & 0xE0) | ((addr >> 8) & 0x1F);
  delayMicroseconds(2);
}
inline uint8_t halReadData() { return PINL; }  // PINx, not PORTx!
inline void halWriteData(uint8_t data) { PORTL = data; DDRL = 0xFF; }
inline void halReleaseData() { DDRL = 0x00; PORTL = 0x00; }

#elif defined(__AVR_ATmega328P__)
// Arduino Uno / Nano: data bus D0-D7 = D2-D9 (PD2-PD7, PB0-PB1).
// Address bus: two 74HC595 on SPI (MOSI D11, SCK D13, latch A2; U1 = A0-A7, U2 = A8-A12),
// or with ADDR_MCP23017 defined the MCP23017 boards (I2C 0x20, GPA0-7 = A0-A7, GPB0-4 = A8-A12).
// #define ADDR_MCP23017
const uint8_t CART_PWR = 10;       // PB2, LOW = cartridge on (BC327)
const uint8_t CART_SENSE = A0;
inline void halReleaseDataPins() {
  DDRD &= 0x03; PORTD &= 0x03;
  DDRB &= 0xFC; PORTB &= 0xFC;
}
#if defined(ADDR_MCP23017)
#include <Wire.h>
const uint8_t MCP_ADDR = 0x20;
inline void mcpWrite(uint8_t reg, uint8_t a, uint8_t b) {
  Wire.beginTransmission(MCP_ADDR);
  Wire.write(reg); Wire.write(a); Wire.write(b);
  Wire.endTransmission();
}
inline void halRelease() {
  mcpWrite(0x00, 0xFF, 0xFF);  // IODIRA/IODIRB: all inputs
  halReleaseDataPins();
}
inline void halDrive() {
  mcpWrite(0x12, 0x00, 0x00);  // GPIOA/GPIOB low before switching to output
  mcpWrite(0x00, 0x00, 0x00);
}
inline void halInit() {
  Wire.begin();
  Wire.setClock(400000);
  halRelease();
}
inline void halSetAddr(uint16_t addr) {
  mcpWrite(0x12, addr & 0xFF, (addr >> 8) & 0x1F);  // GPIOA/GPIOB
}
#else
#include <SPI.h>
const uint8_t SR_LATCH = A2;
inline void halSetAddr(uint16_t addr) {
  SPI.transfer((addr >> 8) & 0x1F);  // shifted on into U2 (A8-A12)
  SPI.transfer(addr & 0xFF);         // stays in U1 (A0-A7)
  digitalWrite(SR_LATCH, HIGH);
  digitalWrite(SR_LATCH, LOW);
}
// The 74HC595 outputs cannot float (OE is tied low); LOW does not feed an unpowered cartridge.
inline void halRelease() {
  halSetAddr(0);
  halReleaseDataPins();
}
inline void halDrive() { halSetAddr(0); }
inline void halInit() {
  pinMode(SR_LATCH, OUTPUT);
  digitalWrite(SR_LATCH, LOW);
  SPI.begin();
  SPI.beginTransaction(SPISettings(4000000, MSBFIRST, SPI_MODE0));
  halRelease();
}
#endif
inline void halPullupD2(bool on) { if (on) PORTD |= 0x10; else PORTD &= ~0x10; }  // D2 = PD4
inline uint8_t halReadData() { return (PIND >> 2) | ((PINB & 0x03) << 6); }
inline void halWriteData(uint8_t data) {
  PORTD = (PORTD & 0x03) | (data << 2);
  PORTB = (PORTB & 0xFC) | (data >> 6);
  DDRD |= 0xFC;
  DDRB |= 0x03;
}
inline void halReleaseData() { halReleaseDataPins(); }
#else
#error "Board not supported (Mega 2560, Uno or Nano)"
#endif
