sfambach/arduino-atari2600-cart-reader/(commit log)

2026-10-08 Add THT shields for Arduino Uno (MCP23017) and Mega 2560
    KiCad 7 projects, schematics, Gerbers and the generator scripts that
    build and route both boards. Pinout matches hal.h.
    Claude-Session: https://claude.ai/code/session_015VQCpzuZ22TPQEmx9cLrbH
    [atari2600-cart-reader-mega.kicad_pcb, atari2600-cart-reader-mega.kicad_sch, atari2600-cart-reader-uno.kicad_pcb, atari2600-cart-reader-uno.kicad_sch]
2026-10-25 Set cartridge slot row spacing to measured 5.5 mm
    Stefan measured 6 mm across the outer pin edges with 0.5 mm pins.
    Both shields re-routed; DRC 0 errors, 0 unconnected.
    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
    [atari2600-cart-reader-mega.kicad_pcb, atari2600-cart-reader-mega.kicad_sch, atari2600-cart-reader-uno.kicad_pcb, atari2600-cart-reader-uno.kicad_sch]
2026-10-25 Add 2D dimension sketch of the cartridge slot
    Hand-measured dimensions with open points marked; basis for the
    planned 3D-printed cartridge guide.
    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
2026-10-25 Slot drawing v2: lower part, four views, without socket-strip adapter
    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
2026-10-25 Slot drawing v3: re-measured length, flange size and height
    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
2026-10-25 Slot drawing v4: flanges flush with lower part, upper part 10.1 mm
    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
2026-10-25 Slot drawing v5: card slot length 33.3 mm
    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
2026-10-25 Slot drawing v6: confirm 3.6 mm above the flanges
    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
2026-10-25 Slot drawing v7: card slot width and spring contacts
    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
2026-10-25 Slot drawing v8: card slot depth 9 mm
    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
2026-10-25 Slot drawing v9: lower part 7.4 mm wide
    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
2026-10-25 Switched cartridge supply, Nano board, guide mounting holes
    - BC327 high-side switch with 200 mA polyfuse and rail sense on all boards
    - Firmware powers the cartridge only after an orientation check
    (experimental thresholds, S command for calibration)
    - New carrier board for a plugged-in Arduino Nano (same circuit and
    firmware as the Uno)
    - Slot footprint with M2.5 flange holes and the guide base plate outline;
    build checks that the plate area stays free
    - ICSP header removed from the shields, Uno hole next to it removed,
    Mega slot moved to the board centre
    - Fix: struct Scheme declared before Arduino's generated prototypes
    (the sketch did not compile before)
    - Switch schematic and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
    [atari2600-cart-reader-mega.kicad_pcb, atari2600-cart-reader-mega.kicad_sch, atari2600-cart-reader-nano.kicad_pcb, atari2600-cart-reader-nano.kicad_sch, atari2600-cart-reader-uno.kicad_pcb, atari2600-cart-reader-uno.kicad_sch]
2026-10-27 Silkscreen: reference and value per part, fambach.net on the front
    labels.py adds the silkscreen texts after routing, so the copper stays unchanged.
    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
    [atari2600-cart-reader-mega.kicad_pcb, atari2600-cart-reader-nano.kicad_pcb, atari2600-cart-reader-uno.kicad_pcb]
2026-10-28 Reset and read buttons on all boards (v1.2)
    SW1 resets the Arduino, SW2 on A1 repeats the last dump; dump.py listen saves button dumps.
    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
    [atari2600-cart-reader-mega.kicad_pcb, atari2600-cart-reader-mega.kicad_sch, atari2600-cart-reader-nano.kicad_pcb, atari2600-cart-reader-nano.kicad_sch, atari2600-cart-reader-uno.kicad_pcb, atari2600-cart-reader-uno.kicad_sch]
2026-10-28 Nano board: read button only, the Nano's own reset button stays reachable
    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
    [atari2600-cart-reader-nano.kicad_pcb, atari2600-cart-reader-nano.kicad_sch]
2026-10-28 Uno/Nano: address bus via two 74HC595 on SPI, MCP23017 boards kept as variants
    hal.h selects the MCP23017 with #define ADDR_MCP23017.
    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
    [atari2600-cart-reader-mega.kicad_pcb, atari2600-cart-reader-mega.kicad_sch, atari2600-cart-reader-nano-mcp23017.kicad_pcb, atari2600-cart-reader-nano-mcp23017.kicad_sch, atari2600-cart-reader-nano.kicad_pcb, atari2600-cart-reader-nano.kicad_sch, atari2600-cart-reader-uno-mcp23017.kicad_pcb, atari2600-cart-reader-uno-mcp23017.kicad_sch]
